maximevince/smartevse/version1/eagle/SmartEVSE.brd

## EAGLE design version1/eagle/SmartEVSE.brd (2019-11-28, an earlier design)

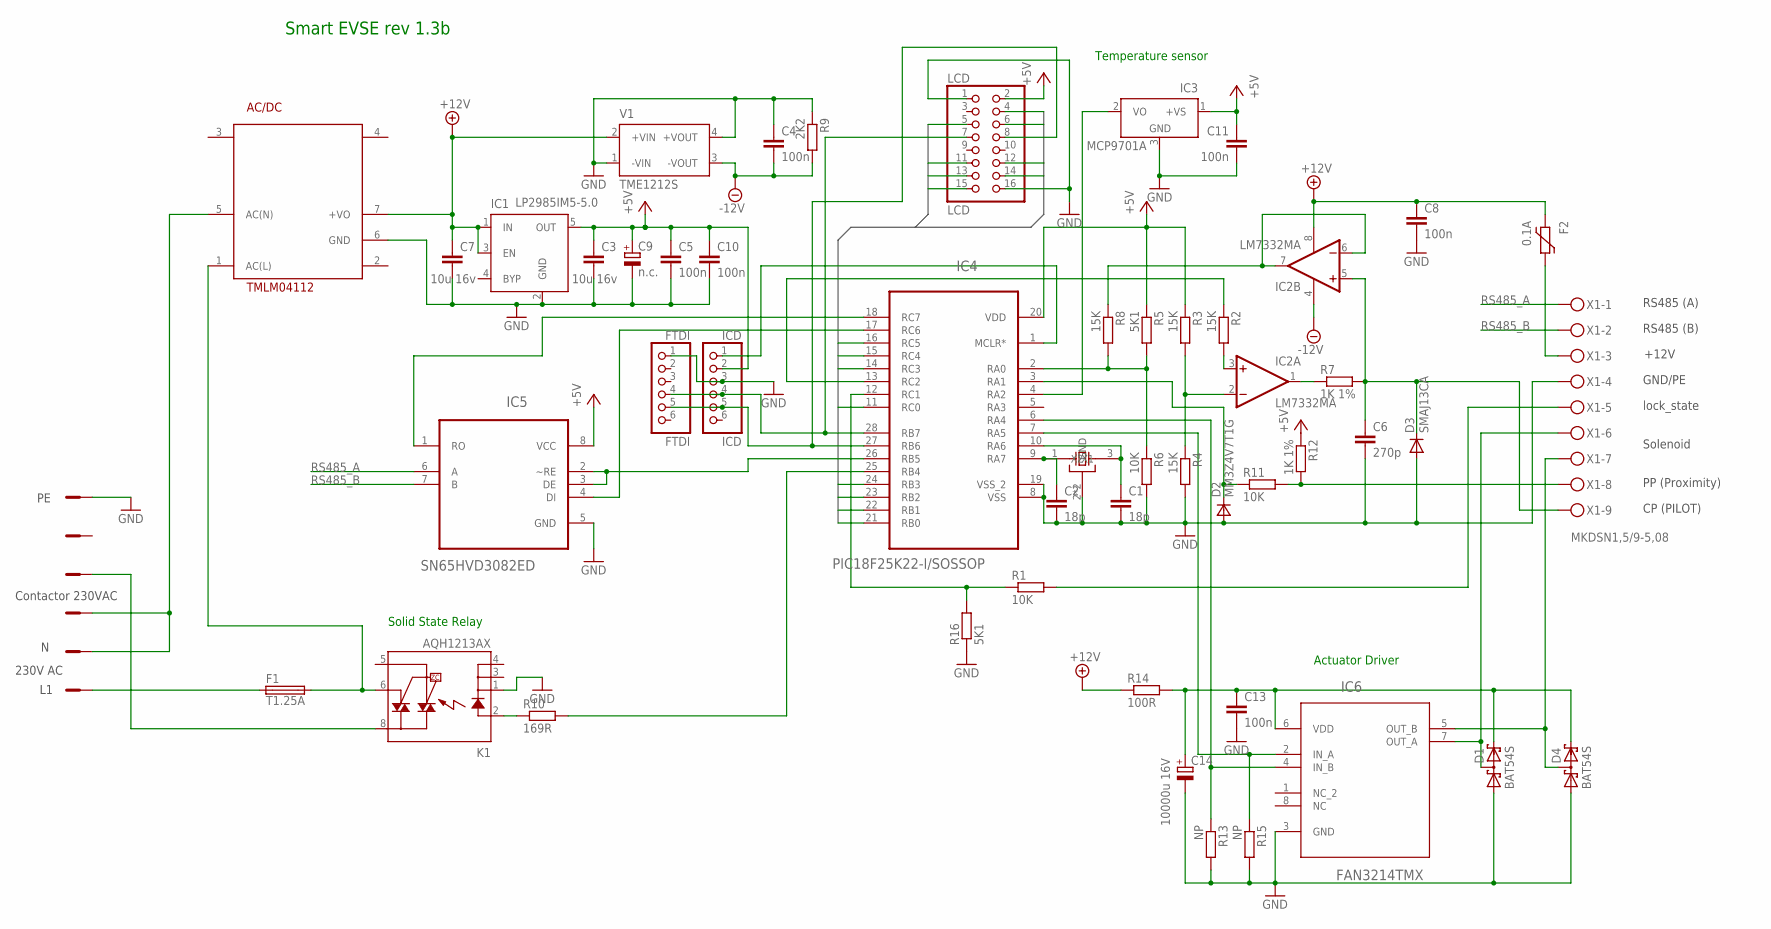
[picture p5: schematic SmartEVSE.sch]

Parts:
AC/DC: TMLM04112; AC/DC
C1, C2: 18p; C0805
C3, C7: 10u 16v; C1206
C4, C5, C8, C10, C11, C13: 100n; C0805
C6: 270p; C0805
C9: n.c.; SMC_C
C14: 10000u 16V; EB22,5D
D1, D4: BAT54S; SOT23
D2: MM3Z4V7T1G; SOD323
D3: SMAJ13CA; DO214AC
F1: T1.25A; TR5
F2: 0.1A; 1206L
FTDI: FTDI; 1X06
IC1: LP2985IM5-5.0; SOT23-5
IC2: LM7332MA; SO08
IC3: MCP9701A; SOT23
IC4: PIC18F25K22-I/SOSSOP; SOP65P780X200-28N
IC5: SN65HVD3082ED; SOIC127P600X175-8N
IC6: FAN3214TMX; SOIC127P600X175-8N
ICD: ICD; 1X06
K1: AQH1213AX; DIL07SMD
LCD: LCD; 2X08
Q1: CTS_32X25_SMD; CTS_32X25
R1, R6, R11: 10K; R0805
R2, R3, R4, R8: 15K; R0805
R5, R16: 5K1; R0805
R7, R12: 1K 1%; R0805
R9: 2K2; R0805
R10: 169R; R0805
R13, R15: NP; R0805
R14: 100R; R0805
V1: TME1212S; TME
X1: MKDSN1,5/9-5,08
X2: AST027-06; P_AST027-06

Connections:
+12V: AC/DC.7 (+VO), C7.1, C8.1, F2.P$1 (1), IC1.1 (IN), IC1.3 (EN), IC2.8 (V+), R14.1, V1.2 (+VIN)
-12V: C4.2, IC2.4 (V-), R9.2, V1.3 (-VOUT)
GND: AC/DC.6 (GND), C1.2, C2.2, C3.2, C4.1, C5.2, C6.2, C7.2, C8.2, C9.-, C10.2, C11.2, C13.2, C14.-, D1.1 (A1), D2.2 (A), D3.A, D4.1 (A1), FTDI.1, IC1.2 (GND), IC3.3 (GND), IC4.8 (VSS), IC4.19 (VSS_2), IC5.5 (GND), IC6.3 (GND), ICD.3, K1.1 (K), LCD.1, LCD.16, Q1.2 (GND), Q1.4 (GND), R4.2, R6.2, R9.1, R13.2, R15.2, R16.1, V1.1 (-VIN), V1.4 (+VOUT), X1.4, X2.P$1
LCD0: IC4.21 (RB0), LCD.11
LCD1: IC4.22 (RB1), LCD.12
LCD2: IC4.23 (RB2), LCD.13
LCD3: IC4.24 (RB3), LCD.14
LCD4: IC4.11 (RC0), LCD.15
LCD6: IC4.14 (RC3), LCD.4
LCD7: IC4.15 (RC4), LCD.5
LCD8: IC4.16 (RC5), LCD.6
unnamed: IC4.12 (RC1), R1.1, R16.2
unnamed: IC4.6 (RA4), IC6.4 (IN_B), R13.1
unnamed: IC4.17 (RC6), IC5.4 (DI)
unnamed: IC4.18 (RC7), IC5.1 (RO)
unnamed: C2.1, IC4.9 (RA7), Q1.1 (X1)
unnamed: C1.1, IC4.10 (RA6), Q1.3 (X2)
unnamed: IC2.2 (-IN), R3.2, R4.1
unnamed: C6.1, D3.C, IC2.5 (+IN), R7.2, X1.9
unnamed: IC4.13 (RC2), R2.1
unnamed: IC2.3 (+IN), R2.2
unnamed: IC4.2 (RA0), R5.2, R6.1, R8.2
unnamed: IC2.1 (OUT), R7.1
unnamed: IC2.6 (-IN), IC2.7 (OUT), R8.1
unnamed: D2.1 (C), IC4.3 (RA1), R11.1
unnamed: C13.1, C14.+, D1.2 (C2), D4.2 (C2), IC6.6 (VDD), R14.2
unnamed: IC4.7 (RA5), IC6.2 (IN_A), R15.1
unnamed: K1.2 (A), R10.1
unnamed: IC4.25 (RB4), R10.2
unnamed: AC/DC.1 (AC(L)), F1.2, K1.6 (DS3)
unnamed: R11.2, R12.2, X1.8
unnamed: K1.8 (DS1), X2.P$3
unnamed: F1.1, X2.P$6
unnamed: IC4.26 (RB5), IC5.2 (~RE), IC5.3 (DE)
unnamed: AC/DC.5 (AC(N)), X2.P$4, X2.P$5
unnamed: D1.3 (C1A2), IC6.7 (OUT_A), X1.6
unnamed: IC4.1 (MCLR*), ICD.1
unnamed: D4.3 (C1A2), IC6.5 (OUT_B), X1.7
unnamed: IC3.2 (VO), IC4.4 (RA2)
unnamed: F2.P$2 (2), X1.3
unnamed: R1.2, X1.5
unnamed: FTDI.4, IC4.28 (RB7), ICD.4, LCD.7
unnamed: FTDI.5, IC4.27 (RB6), ICD.5, LCD.8
RS485_A: IC5.6 (A), X1.1
RS485_B: IC5.7 (B), X1.2
VCC: C3.1, C5.1, C9.+, C10.1, C11.1, IC1.5 (OUT), IC3.1 (+VS), IC4.20 (VDD), IC5.8 (VCC), ICD.2, LCD.2, R3.1, R5.1, R12.1

Notes on the sheet:
230V AC
Solenoid
lock_state
+12V
CP (PILOT)
PP (Proximity)
GND/PE
RS485 (A)
RS485 (B)
Contactor 230VAC
Smart EVSE rev 1.3b
Temperature sensor
Actuator Driver
Solid State Relay

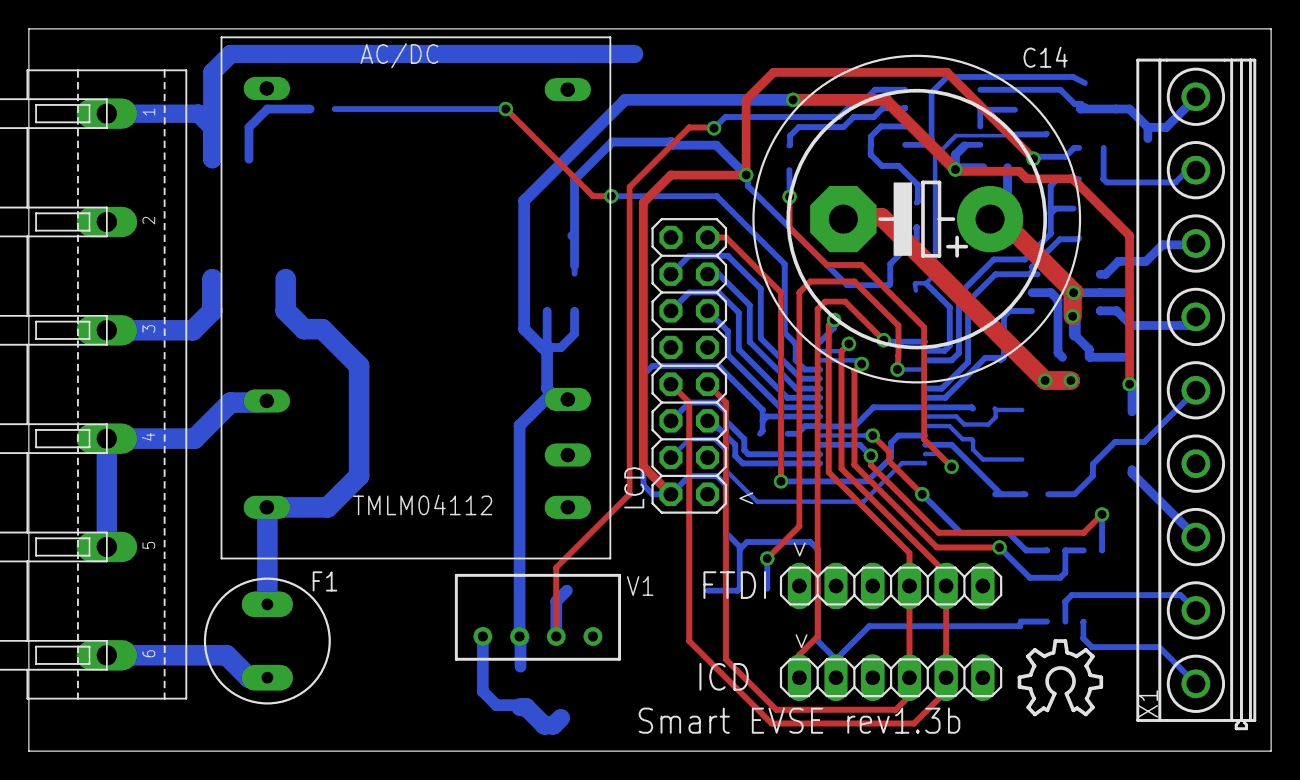
[picture p6: board SmartEVSE.brd from above]

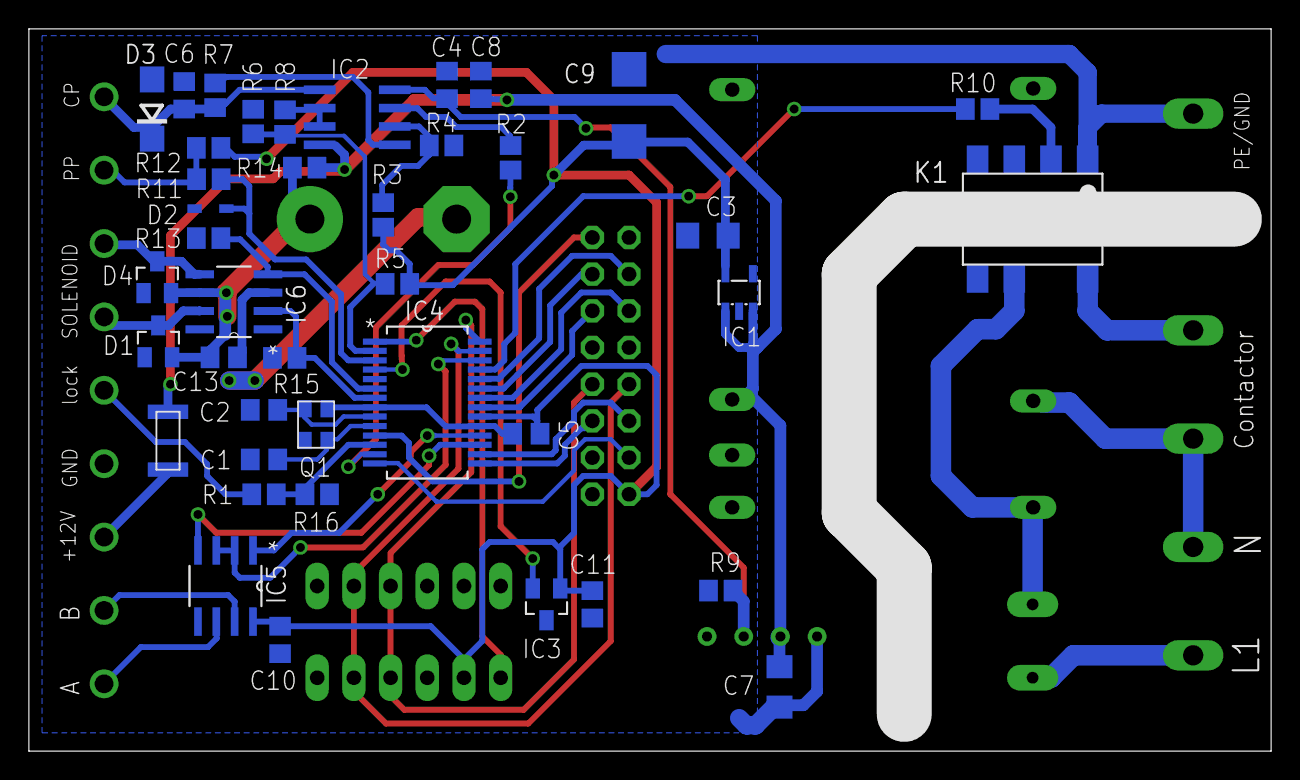
[picture p7: board SmartEVSE.brd from below]

Board: 2 copper layers, 86.0 x 50.0 mm, 51 parts (41 on the bottom side), 46 nets.

Other parts of the board:
U$1: OSHW_10X200_NOTEXT
