maximevince/smartevse/version1/eagle/3PCurrentTX.brd

## EAGLE design version1/eagle/3PCurrentTX.brd (2019-11-28, an earlier design)

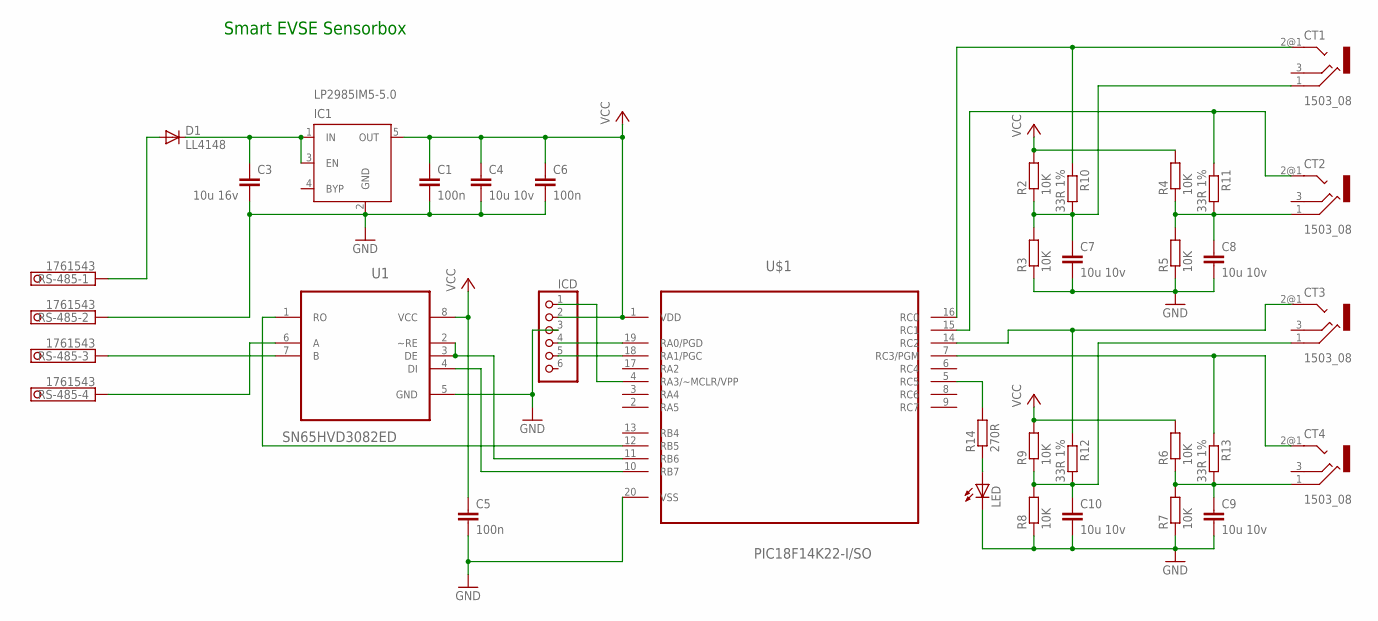
[picture p11: schematic 3PCurrentTX.sch]

Parts:
C1, C5, C6: 100n; C0805K
C3: 10u 16v; C1206K
C4, C7, C8, C9, C10: 10u 10v; C0805K
CT1, CT2, CT3, CT4: 1503_08
D1: LL4148; SOD123
IC1: LP2985IM5-5.0; SOT23-5
ICD: PINHD-1X6; 1X06
LED: LEDSML0805; SML0805
R2, R3, R4, R5, R6, R7, R8, R9: 10K; R0805
R10, R11, R12, R13: 33R 1%; R0805
R14: 270R; R0805
RS-485: 1761543; 1751264
U1: SN65HVD3082ED; SOIC127P600X175-8N
U$1: PIC18F14K22-I/SO; SOIC127P1030X265-20N; MPN PIC18F14k22-I/SO

Connections:
GND: C1.2, C3.2, C4.2, C5.2, C6.2, C7.2, C8.2, C9.2, C10.2, IC1.2 (GND), ICD.3, LED.C, R3.1, R5.1, R7.1, R8.1, RS-485.2, U1.5 (GND), U$1.20 (VSS)
unnamed: D1.A, RS-485.1
unnamed: R14.2, U$1.5 (RC5)
unnamed: U1.1 (RO), U$1.12 (RB5)
unnamed: U1.4 (DI), U$1.10 (RB7)
unnamed: U1.2 (~RE), U1.3 (DE), U$1.11 (RB6)
unnamed: CT1.2@1 (2), R10.1, U$1.16 (RC0)
unnamed: LED.A, R14.1
unnamed: CT3.2@1 (2), R12.1, U$1.14 (RC2)
unnamed: CT4.2@1 (2), R13.1, U$1.7 (RC3/PGM)
unnamed: CT2.2@1 (2), R11.1, U$1.15 (RC1)
unnamed: RS-485.3, U1.7 (B)
unnamed: RS-485.4, U1.6 (A)
unnamed: C7.1, CT1.1, R2.1, R3.2, R10.2
unnamed: C3.1, D1.C, IC1.1 (IN), IC1.3 (EN)
unnamed: ICD.5, U$1.18 (RA1/PGC)
unnamed: C8.1, CT2.1, R4.1, R5.2, R11.2
unnamed: ICD.1, U$1.4 (RA3/~MCLR/VPP)
unnamed: C10.1, CT3.1, R8.2, R9.1, R12.2
unnamed: C9.1, CT4.1, R6.1, R7.2, R13.2
unnamed: ICD.4, U$1.19 (RA0/PGD)
VCC: C1.1, C4.1, C5.1, C6.1, IC1.5 (OUT), ICD.2, R2.2, R4.2, R6.2, R9.2, U1.8 (VCC), U$1.1 (VDD)

Notes on the sheet:
Smart EVSE Sensorbox

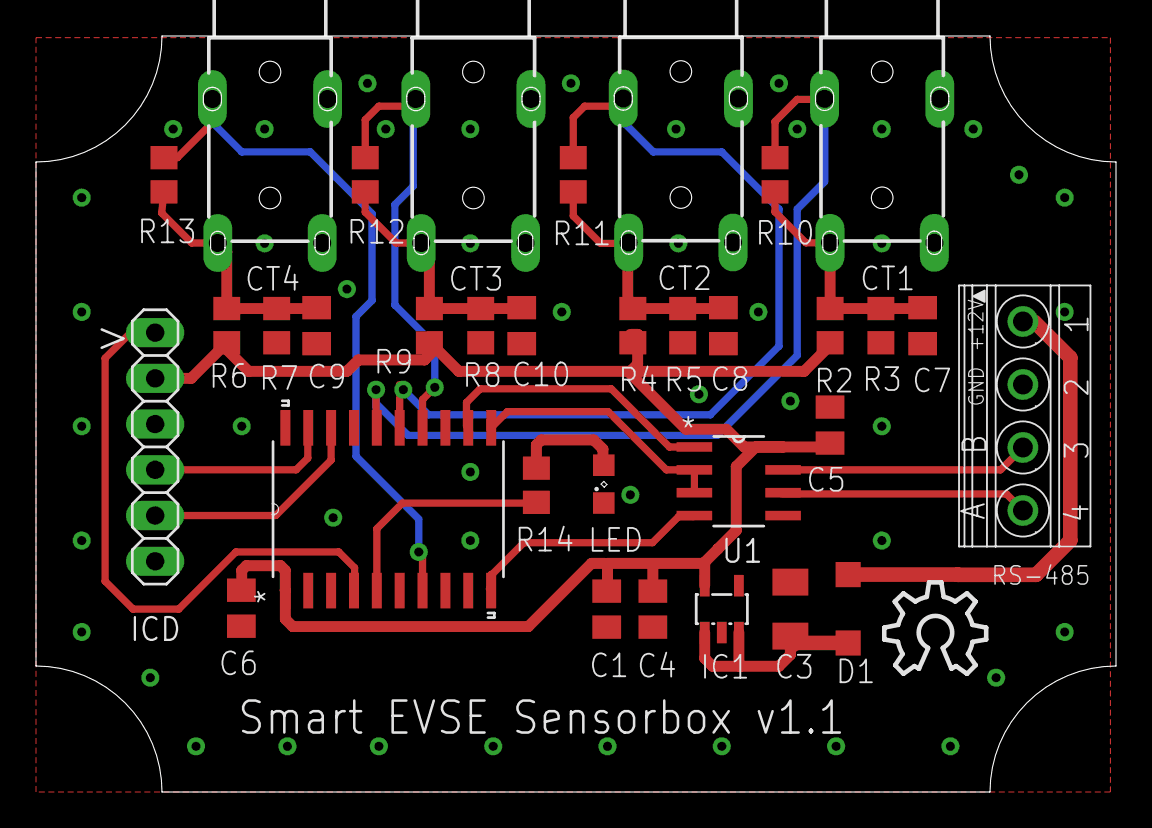
[picture p12: board 3PCurrentTX.brd from above]

Board: 2 copper layers, 60.0 x 42.0 mm, 34 parts (0 on the bottom side), 22 nets.

Other parts of the board:
U$2: OSHW_10X200_NOTEXT
