maximevince/smartevse/(commit log)

2019-11-28 Move version1 to separate directory
    [3PCurrentTX.brd, 3PCurrentTX.sch, LCD_board.brd, LCD_board.sch, SmartEVSE.brd, SmartEVSE.sch]
2019-11-28 Add Kicad EDA files (imported from Eagle)
    [SmartEVSEv2.2.kicad_pcb, SmartEVSEv2.2.sch]
2019-11-29 Add Kicad EDA files (imported from Eagle) (2)
    [LCD_boardv2.kicad_pcb, LCD_boardv2.sch, SmartEVSEv2.2.brd, SmartEVSEv2.2.kicad_pcb, SmartEVSEv2.2.sch]
2019-11-29 Some basic refactoring, using fixed-width datatypes, enums, ...
    [EVSE.c, EVSE.h, GLCD.c, GLCD.h]
